arijav/ARILO-RF-Receiver-Transmitter/README.md

# ARILO-RF-Receiver-Transmitter
Open Source / Hardware receiver transmitter for remote controlled model vehicles based on STM32 MCU´s

The PCB's for the transmitter and receiver are shared in OSH Park:
https://oshpark.com/profiles/arigita/
