arijav/ARILO-RF-Receiver-Transmitter/PCB_Design/150109_Modification_Required_Last_Designs.docx

Usarttx 1 y rx están mal, hay que cambiarlos de lado.

Comprobar si diseño de usart es correcto

Ver como están conectados en Taranis vs 9x
