arijav/ARILO-RF-Receiver-Transmitter/PCB_Design/130818_I_T_V_AriloRX_FINAL.brd

## EAGLE design PCB_Design/130818_I_T_V_AriloRX_FINAL.brd (2020-05-03)

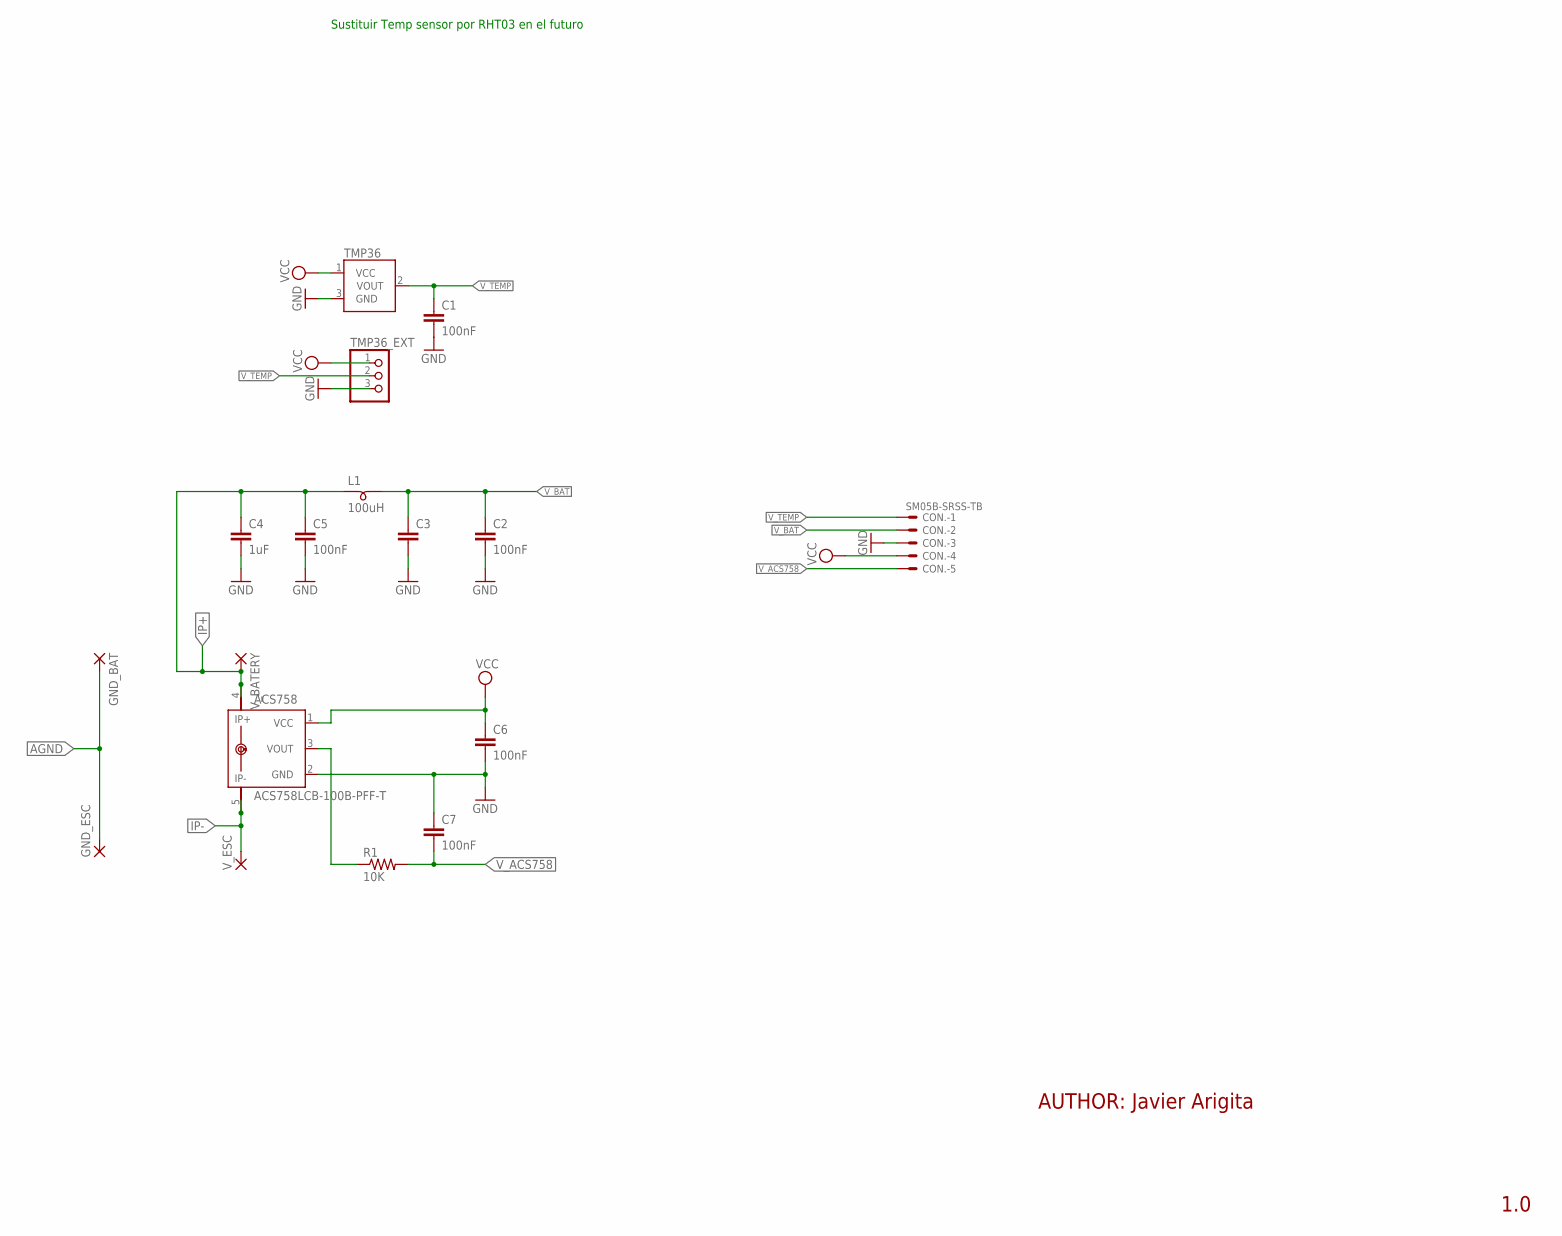
[picture p1: schematic 130818_I_T_V_AriloRX_FINAL.sch]

Parts:
ACS758: ACS758LCB-100B-PFF-T; CB-PFF
C1, C2, C5, C6, C7: 100nF; C0805
C3: C-EUC3216; C3216
C4: 1uF; C3216
CON.: SM05B-SRSS-TB
GND_BAT: SMD5; SMD2,54-5,08
GND_ESC: SMD5; SMD2,54-5,08
L1: 100uH; SM-B5
R1: 10K; R0805
TMP36: TMP36GT9; TO-92
TMP36_EXT: PINHD-1X3; 1X03
V_BATERY: SMD5; SMD2,54-5,08
V_ESC: SMD5; SMD2,54-5,08

Connections:
AGND: GND_BAT.1, GND_ESC.1
GND: ACS758.2 (GND), C1.2, C2.2, C3.2, C4.2, C5.2, C6.2, C7.1, CON..3, TMP36.3 (GND), TMP36_EXT.3
IP+: ACS758.4 (IP+), ACS758.IP+1, C4.1, C5.1, L1.1, V_BATERY.1
IP-: ACS758.5 (IP-), ACS758.IP-1, V_ESC.1
unnamed: ACS758.3 (VOUT), R1.1
VCC: ACS758.1 (VCC), C6.1, CON..4, TMP36.1 (VCC), TMP36_EXT.1
V_ACS758: C7.2, CON..5, R1.2
V_BAT: C2.1, C3.1, CON..2, L1.2
V_TEMP: C1.1, CON..1, TMP36.2 (VOUT), TMP36_EXT.2

Notes on the sheet:
AUTHOR: Javier Arigita
1.0
Sustituir Temp sensor por RHT03 en el futuro

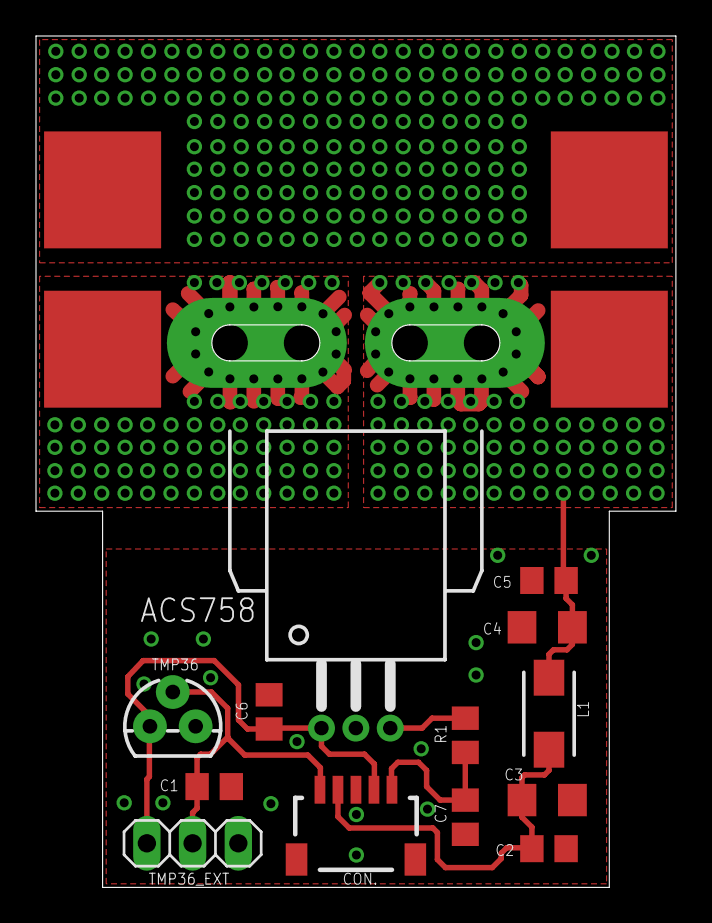
[picture p2: board 130818_I_T_V_AriloRX_FINAL.brd from above]

Board: 2 copper layers, 35.6 x 47.3 mm, 17 parts (0 on the bottom side), 9 nets.
