arijav/ARILO-RF-Receiver-Transmitter/PCB_Design/130627_ReceiverSTM_0_0.brd

## EAGLE design PCB_Design/130627_ReceiverSTM_0_0.brd (2020-05-03)

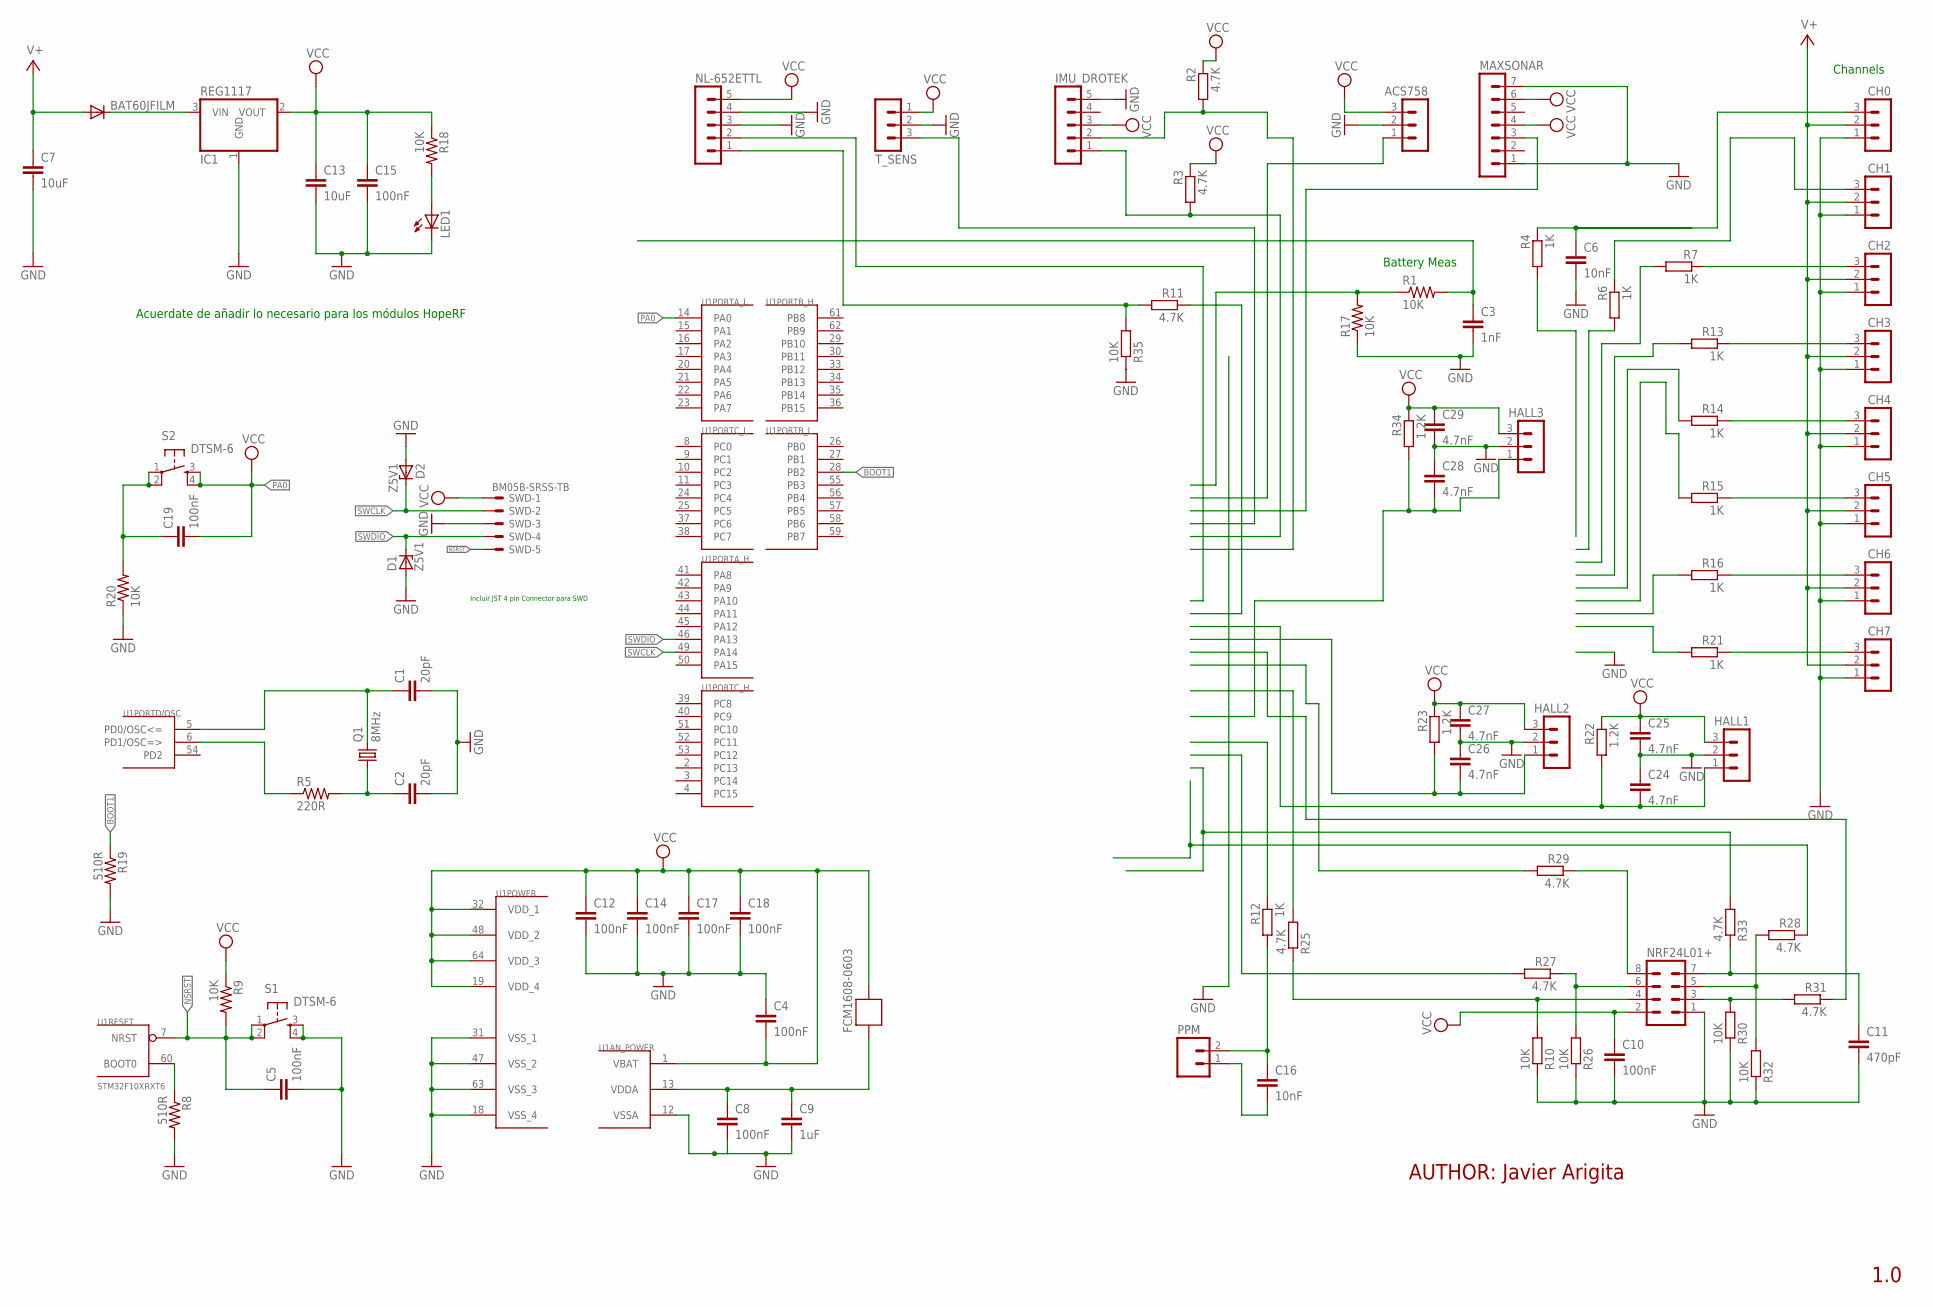
[picture p3: schematic 130627_ReceiverSTM_0_0.sch]

Parts:
ACS758: MA03-1
BAT60JFILM: DIODE-SOD323-R; SOD323-R
C1, C2: 20pF; C0805
C3: 1nF; C0805
C4, C5, C8, C10, C12, C14, C15, C17, C18, C19: 100nF; C0805
C6, C16: 10nF; C025-030X050
C7, C13: 10uF; C3216
C9: 1uF; C3216
C11: 470pF; C025-030X050
C24, C25, C26, C27, C28, C29: 4.7nF; C025-030X050
CH0, CH1, CH2, CH3, CH4, CH5, CH6, CH7: MA03-1
D1, D2: Z5V1; SOD80C
FCM1608-0603: FERRITE-BEAD; R0603
HALL1, HALL2, HALL3: MA03-1
IC1: REG1117; SOT223
IMU_DROTEK: MA05-1
LED1: LED0805; CHIPLED_0805
MAXSONAR: MA07-1
NL-652ETTL: MA05-1
NRF24L01+: MA04-2
PPM: M02; 02P
Q1: 8MHz; SM49
R1, R9, R17, R18, R20: 10K; R0805
R2, R3, R11, R25, R27, R28, R29, R31, R33: 4.7K; 0204/7
R4, R6, R7, R12, R13, R14, R15, R16, R21: 1K; 0204/7
R5: 220R; R0805
R8, R19: 510R; R0805
R10, R26, R30, R32, R35: 10K; 0204/7
R22, R23, R34: 1.2K; 0204/7
S1, S2: DTSM-6
SWD: BM05B-SRSS-TB
T_SENS: MA03-1
U1: STM32F10XRXT6; TQFP64

Connections:
BOOT1: R19.1, U1.28 (PB2)
GND: ACS758.2, C1.2, C2.2, C3.2, C4.1, C5.2, C6.2, C7.2, C8.2, C9.2, C10.2, C11.2, C12.2, C13.2, C14.2, C15.2, C17.2, C18.2, C24.1, C25.2, C26.1, C27.2, C28.1, C29.2, CH0.1, CH1.1, CH2.1, CH3.1, CH4.1, CH5.1, CH6.1, CH7.1, D1.A, D2.A, HALL1.2, HALL2.2, HALL3.2, IC1.1 (GND), IMU_DROTEK.5, LED1.C, MAXSONAR.1, MAXSONAR.7, NL-652ETTL.3, NL-652ETTL.4, NRF24L01+.1, R8.2, R10.1, R17.1, R19.2, R20.1, R26.1, R30.1, R32.1, R35.1, S1.3, S1.4, T_SENS.2, U1.12 (VSSA), U1.18 (VSS_4), U1.31 (VSS_1), U1.47 (VSS_2), U1.63 (VSS_3)
MAX_BRIDGE: NL-652ETTL.2
unnamed: C1.1, Q1.2, U1.5 (PD0/OSC<=)
unnamed: R5.1, U1.6 (PD1/OSC=>)
unnamed: C2.1, Q1.1, R5.2
unnamed: R8.1, U1.60 (BOOT0)
unnamed: C19.1, R20.2, S2.1, S2.2
unnamed: ACS758.3, C25.1, C27.1, C29.1, HALL1.3, HALL2.3, HALL3.3, IMU_DROTEK.3, MAXSONAR.4, MAXSONAR.6, NL-652ETTL.5, R2.1, R3.1, R22.1, R23.1, R34.1, T_SENS.1
unnamed: C16.2, PPM.1
unnamed: IMU_DROTEK.2, R2.2
unnamed: LED1.A, R18.2
unnamed: C28.2, HALL3.1, R34.2
unnamed: BAT60JFILM.C, IC1.3 (VIN)
unnamed: C24.2, HALL1.1, R22.2
unnamed: C3.1, R1.2
unnamed: C8.1, C9.1, FCM1608-0603.2, U1.13 (VDDA)
unnamed: NRF24L01+.4, R10.2, R25.1
unnamed: NRF24L01+.3, R30.2, R31.2
unnamed: C16.1, PPM.2, R12.2
unnamed: NL-652ETTL.1, R11.2, R35.2
unnamed: IMU_DROTEK.1, R3.2
unnamed: C26.2, HALL2.1, R23.2
unnamed: R1.1, R17.2
unnamed: NRF24L01+.8, R29.1
unnamed: NRF24L01+.6, R26.2, R27.1
unnamed: NRF24L01+.5, R28.2, R32.2
unnamed: C11.1, NRF24L01+.7, R33.1
unnamed: C6.1, CH0.3, R4.1
unnamed: CH1.3, R6.1
unnamed: CH2.3, R7.1
unnamed: CH3.3, R13.1
unnamed: CH4.3, R14.1
unnamed: CH5.3, R15.1
unnamed: CH6.3, R16.1
unnamed: CH7.3, R21.1
NSRST: C5.1, R9.2, S1.1, S1.2, SWD.5, U1.7 (NRST)
PA0: C4.2, C10.1, C12.1, C13.1, C14.1, C15.1, C17.1, C18.1, C19.2, FCM1608-0603.1, IC1.2 (VOUT), NRF24L01+.2, R9.1, R18.1, S2.3, S2.4, U1.1 (VBAT), U1.14 (PA0), U1.19 (VDD_4), U1.48 (VDD_2), U1.64 (VDD_3)
SWCLK: D2.C, SWD.2, SWD.3, U1.49 (PA14)
SWDIO: D1.C, SWD.4, U1.46 (PA13)
V+: BAT60JFILM.A, C7.1, CH0.2, CH1.2, CH2.2, CH3.2, CH4.2, CH5.2, CH6.2, CH7.2
VCC: SWD.1
VDD_1: U1.32 (VDD_1)

Notes on the sheet:
Battery Meas
Acuerdate de añadir lo necesario para los módulos HopeRF
AUTHOR: Javier Arigita
1.0
Channels
Incluir JST 4 pin Connector para SWD

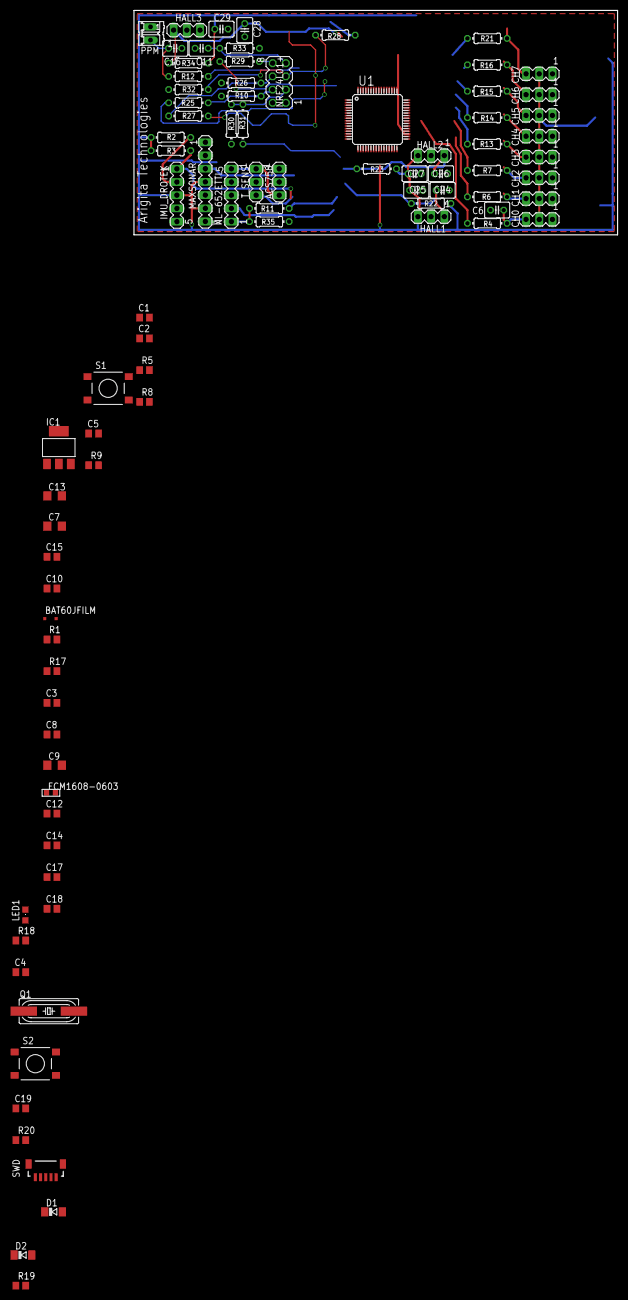
[picture p4: board 130627_ReceiverSTM_0_0.brd from above]

Board: 2 copper layers, 93.0 x 43.2 mm, 88 parts (0 on the bottom side), 40 nets.
