arijav/ARILO-RF-Receiver-Transmitter/PCB_Design/150309_AriloRX_REV3_0_0.brd

## EAGLE design PCB_Design/150309_AriloRX_REV3_0_0.brd (2020-05-03, an earlier design)

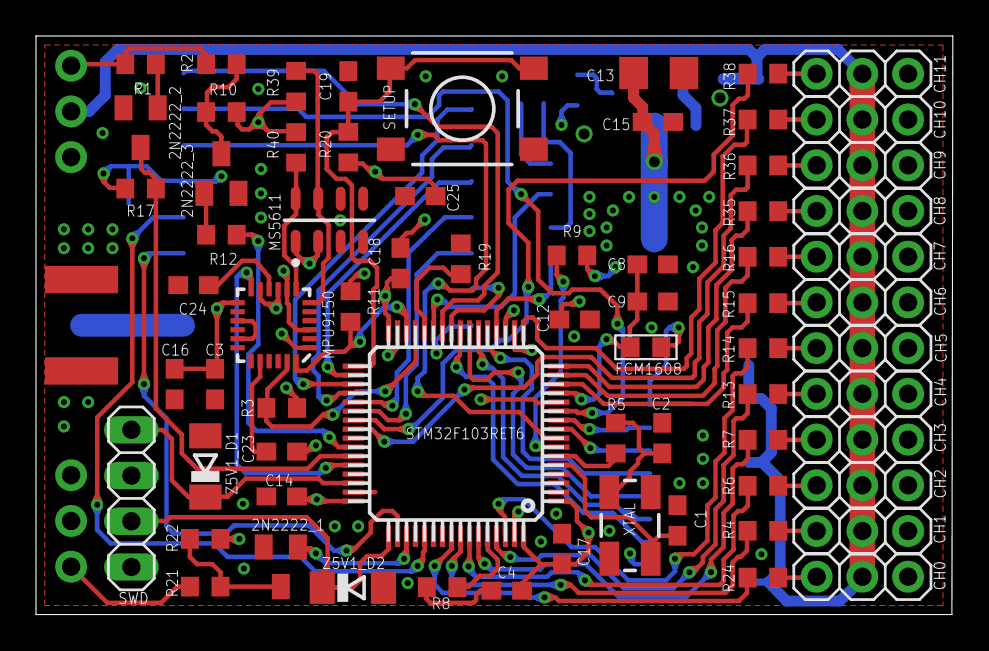
[picture p5: board 150309_AriloRX_REV3_0_0.brd from above]

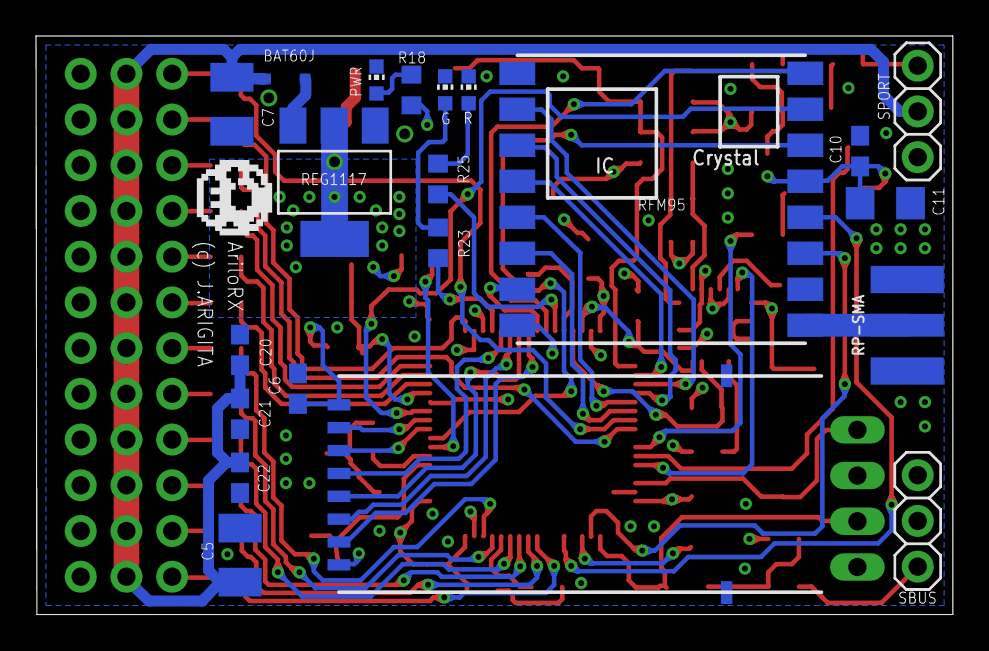
[picture p6: board 150309_AriloRX_REV3_0_0.brd from below]

Board: 4 copper layers, 50.9 x 32.1 mm, 90 parts (21 on the bottom side), 77 nets.

Parts:
2N2222_1, 2N2222_2, 2N2222_3: SOT23-BEC
BAT60J: SOD323-R
C1, C2: 12pF; RESISTOR_C0603
C3, C4, C6, C8, C10, C12, C14, C15, C17, C18, C19, C20, C24, C25: 100nF; RESISTOR_C0603
C5: SMC_B
C7: 100uF; SMC_B
C9: 1uF; RESISTOR_C0603
C11, C13: 10uF; RESISTOR_C3216
C16, C21: 10nF; RESISTOR_C0603
C22: 1nF; RESISTOR_C0603
C23: 2.2nF; RESISTOR_C0603
CH0, CH1, CH2, CH3, CH4, CH5, CH6, CH7, CH8, CH9, CH10, CH11: 1X03
FCM1608: R0603
G: CHIP-LED0603
MPU9150: QFN-24-NP
MS5611: MS5611-01BA03; SON125P300X500X100-8N
NRF24L01_SMD: NRF24L01+_NRF24L01_SMDSMD; NRF24L01+_NRF24L01_SMD
PWR: LED_CHIP-LED0603
R: CHIP-LED0603
R1, R9, R18, R20: 10K; RCL_R0603
R2, R4, R6, R7, R10, R12, R13, R14, R15, R16, R21, R22, R24, R35, R36, R37, R38: 1K; RCL_R0603
R3, R11, R17, R39, R40: 4.7K; RCL_R0603
R5: 80R; RCL_R0603
R8, R19: 510R; RCL_R0603
R23, R25: 220; RCL_R0603
REG1117: REG1117; SOT223
RFM95: RFM95W_MISIEK_RFM95WSMD; RFM95W_MISIEK_RFM95W_SMD
RP-SMA: SMA_EDGELAUNCH
SBUS: 1X03
SETUP: DTSM-6
SPORT: 1X03
STM32F103RET6: STM32F103RET6; TQFP64
SWD: 1X04
XTAL: 12MHz; CRYSTAL-SMD-5X3
Z5V1_D1, Z5V1_D2: Z5V1; SOD80C

Connections:
BOOT1: R19.1, STM32F103RET6.28
CH0: R24.2, STM32F103RET6.56
CH1: R4.2, STM32F103RET6.57
CH2: R6.2, STM32F103RET6.58
CH3: R7.2, STM32F103RET6.59
CH4: R13.2, STM32F103RET6.61
CH5: R14.2, STM32F103RET6.62
CH6: R15.2, STM32F103RET6.14
CH7: R16.2, STM32F103RET6.15
CH8: R35.2, STM32F103RET6.16
CH9: R36.2, STM32F103RET6.40
CH10: R37.2, STM32F103RET6.17
CH11: R38.2, STM32F103RET6.39
GND: 2N2222_1.E, 2N2222_2.E, 2N2222_3.E, C1.2, C2.2, C3.2, C4.1, C5.-, C6.2, C7.-, C8.2, C9.2, C10.2, C11.2, C12.2, C13.2, C14.2, C15.2, C16.2, C17.2, C18.2, C19.1, C20.2, C21.2, C22.2, C23.2, C24.2, C25.2, CH0.1, CH1.1, CH2.1, CH3.1, CH4.1, CH5.1, CH6.1, CH7.1, CH8.1, CH9.1, CH10.1, CH11.1, G.C, MPU9150.1, MPU9150.9, MPU9150.11, MPU9150.15, MPU9150.17, MPU9150.18, MS5611.3, MS5611.4, MS5611.5, NRF24L01_SMD.P$1, PWR.C, R.C, R8.2, R19.2, REG1117.1, RFM95.1, RFM95.8, RFM95.10, RP-SMA.GND@1, RP-SMA.GND@2, RP-SMA.GND@3, RP-SMA.GND@4, SBUS.3, SETUP.1, SETUP.2, SPORT.3, STM32F103RET6.12, STM32F103RET6.18, STM32F103RET6.31, STM32F103RET6.47, STM32F103RET6.63, SWD.3, Z5V1_D1.A, Z5V1_D2.A
HOPERF_CSN: RFM95.5, STM32F103RET6.37
HOPERF_DIO0: RFM95.14, STM32F103RET6.8
HOPERF_DIO1: RFM95.15, STM32F103RET6.11
HOPERF_DIO2: RFM95.16, STM32F103RET6.26
HOPERF_DIO3: RFM95.11, STM32F103RET6.50
HOPERF_DIO4: RFM95.12, STM32F103RET6.53
HOPERF_DIO5: RFM95.7, STM32F103RET6.25
HOPERF_RESET: RFM95.6, STM32F103RET6.38
I2C2_SCL: MPU9150.23, R3.2, STM32F103RET6.29
I2C2_SDA: MPU9150.24, R11.1, STM32F103RET6.30
INP_1: C19.2, R20.1, SETUP.3, SETUP.4, STM32F103RET6.33
LED_GREEN: R23.2, STM32F103RET6.20
LED_RED: R25.2, STM32F103RET6.27
MPU_INT: MPU9150.12, STM32F103RET6.44
unnamed: C1.1, STM32F103RET6.5, XTAL.3
unnamed: R5.1, STM32F103RET6.6
unnamed: C2.1, R5.2, XTAL.1
unnamed: R8.1, STM32F103RET6.60
unnamed: 2N2222_3.C, R2.2, R10.2
unnamed: RFM95.9, RP-SMA.P
unnamed: 2N2222_3.B, R12.1
unnamed: CH0.3, R24.1
unnamed: PWR.A, R18.2
unnamed: 2N2222_1.C, R21.2, R22.2
unnamed: G.A, R23.1
unnamed: CH8.3, R35.1
unnamed: R1.1, R2.1, SPORT.1
unnamed: R.A, R25.1
unnamed: 2N2222_2.B, R1.2
unnamed: C8.1, C9.1, FCM1608.2, STM32F103RET6.13
unnamed: CH2.3, R6.1
unnamed: CH4.3, R13.1
unnamed: CH9.3, R36.1
unnamed: CH10.3, R37.1
unnamed: CH11.3, R38.1
unnamed: MPU9150.7, MS5611.8, R40.1
unnamed: MPU9150.6, MS5611.7, R39.2
unnamed: CH3.3, R7.1
unnamed: CH6.3, R15.1
unnamed: C23.1, MPU9150.20
unnamed: CH5.3, R14.1
unnamed: CH7.3, R16.1
unnamed: C24.1, MPU9150.10
unnamed: CH1.3, R4.1
NRF_CE: NRF24L01_SMD.P$7, STM32F103RET6.10
NRF_CSN: NRF24L01_SMD.P$6, STM32F103RET6.9
NRF_IRQ: NRF24L01_SMD.P$2, STM32F103RET6.24
NSRST: R9.2, STM32F103RET6.7
SBUS: R21.1, SBUS.1
SPI1_MISO: NRF24L01_SMD.P$3, STM32F103RET6.22
SPI1_MOSI: NRF24L01_SMD.P$4, STM32F103RET6.23
SPI1_SCK: NRF24L01_SMD.P$5, STM32F103RET6.21
SPI2_MISO: RFM95.2, STM32F103RET6.35
SPI2_MOSI: RFM95.3, STM32F103RET6.36
SPI2_SCK: RFM95.4, STM32F103RET6.34
SWCLK: STM32F103RET6.49, SWD.2, Z5V1_D2.C
SWDIO: STM32F103RET6.46, SWD.4, Z5V1_D1.C
USART1_RX: 2N2222_2.C, R17.2, STM32F103RET6.43
USART1_TX: R12.2, STM32F103RET6.42
USART3_TX: 2N2222_1.B, STM32F103RET6.51
V+: BAT60J.A, C5.+, C7.+, C20.1, C21.1, C22.1, CH0.2, CH1.2, CH2.2, CH3.2, CH4.2, CH5.2, CH6.2, CH7.2, CH8.2, CH9.2, CH10.2, CH11.2, SBUS.2, SPORT.2
VCC: C3.1, C4.2, C6.1, C10.1, C11.1, C12.1, C13.1, C14.1, C15.1, C16.1, C17.1, C18.1, C25.1, FCM1608.1, MPU9150.3, MPU9150.8, MPU9150.13, MS5611.1, MS5611.2, NRF24L01_SMD.P$8, R3.1, R9.1, R10.1, R11.2, R17.1, R18.1, R20.2, R22.1, R39.1, R40.2, REG1117.2, REG1117.4, RFM95.13, STM32F103RET6.1, STM32F103RET6.19, STM32F103RET6.32, STM32F103RET6.48, STM32F103RET6.64, SWD.1
VDD: BAT60J.C, REG1117.3
