arijav/ARILO-RF-Receiver-Transmitter/ARILO_RX/src/Project_Files/main.c

/*------------------------------------------------------------------------------*/
/*                                                                              */
/* NAME:             main.c                                                     */
/*                                                                              */
/* DESCRIPTION:      Main function. Call every Task and distribute events among */
/*                   State Machines                                             */
/*                                                                              */
/* VERSION:          1.0                                                        */
/*                                                                              */
/*------------------------------------------------------------------------------*/

/*------------------------------------------------------------------------------*/
/* Header-Files (#include)                                                      */
/*------------------------------------------------------------------------------*/
#include "Event_Manager/event_manager.h"
#include "Event_Manager/state_machine_fw.h"
#include "System/HAL/hw_general.h"

/*------------------------------------------------------------------------------*/
/* Global Variables                                                             */
/*------------------------------------------------------------------------------*/

/*------------------------------------------------------------------------------*/
/* Local Variables                                                              */
/*------------------------------------------------------------------------------*/

/*------------------------------------------------------------------------------*/
/* Local Function Prototypes                                                    */
/*------------------------------------------------------------------------------*/

/*------------------------------------------------------------------------------*/
/* Functions                                                                    */
/*------------------------------------------------------------------------------*/

int main(void)
{
	/* Initiate State Machines */
    init_statem();

	/* Initial setup of the system HW */
	hw_init();

	/* Delegates the task execution into the event manager processor */
	event_processor_main();

	return 0;
}
