arijav/ARILO-RF-Receiver-Transmitter/ARILO_RX/src/Project_Files/System/Modules/RF/hw_hoperf.h

/*------------------------------------------------------------------------------*/
/*                                                                              */
/* NAME:             hw_hoperf.h                                                */
/*                                                                              */
/* DESCRIPTION:      Control Transceiver RFM23bp                                */
/*                                                                              */
/* VERSION:          1.0                                                        */
/*                                                                              */
/*------------------------------------------------------------------------------*/

#ifndef HW_HOPERF_H_
#define HW_HOPERF_H_

/*------------------------------------------------------------------------------*/
/* Header-Files (#include)                                                      */
/*------------------------------------------------------------------------------*/
#include "Arilo_Types.h"

/*------------------------------------------------------------------------------*/
/* Defines                                                                      */
/*------------------------------------------------------------------------------*/

/* Rates */
#define RATE_VERYSLOW 1
#define RATE_SLOW     2
#define RATE_FAST     3

// This is the bit in the SPI address that marks it as a write
#define HOPERF_SPI_WRITE_MASK 0x80

// This is the maximum message length that can be supported by this library. Limited by
// the single message length octet in the header.
// Yes, 255 is correct even though the FIFO size in the HOPERF is only
// 64 octets. We use interrupts to refill the Tx FIFO during transmission and to empty the
// Rx FIFO during reception
// Can be pre-defined to a smaller size (to save SRAM) prior to including this header
#define HOPERF_MAX_MESSAGE_LEN_TX SL_TX_PLOAD_WIDTH
#define HOPERF_MAX_MESSAGE_LEN_RX SL_RX_PLOAD_WIDTH

// Max number of octets the HOPERF Rx and Tx FIFOs can hold
#define HOPERF_FIFO_SIZE 64

// Keep track of the mode the HOPERF is in
#define HOPERF_MODE_IDLE         0
#define HOPERF_MODE_RX           1
#define HOPERF_MODE_TX           2

// These values we set for FIFO thresholds (4, 55) are actually the same as the POR values
#define HOPERF_TXFFAEM_THRESHOLD 4
#define HOPERF_RXFFAFULL_THRESHOLD 55

// This is the default node address,
#define HOPERF_DEFAULT_NODE_ADDRESS 0x12

// This address in the TO addreess signifies a broadcast
#define HOPERF_BROADCAST_ADDRESS 0xff

// Number of registers to be passed to setModemConfig()
#define HOPERF_NUM_MODEM_CONFIG_REGS 18

// Register names
#define HOPERF_REG_00_DEVICE_TYPE                         0x00
#define HOPERF_REG_01_VERSION_CODE                        0x01
#define HOPERF_REG_02_DEVICE_STATUS                       0x02
#define HOPERF_REG_03_INTERRUPT_STATUS1                   0x03
#define HOPERF_REG_04_INTERRUPT_STATUS2                   0x04
#define HOPERF_REG_05_INTERRUPT_ENABLE1                   0x05
#define HOPERF_REG_06_INTERRUPT_ENABLE2                   0x06
#define HOPERF_REG_07_OPERATING_MODE1                     0x07
#define HOPERF_REG_08_OPERATING_MODE2                     0x08
#define HOPERF_REG_09_OSCILLATOR_LOAD_CAPACITANCE         0x09
#define HOPERF_REG_0A_UC_OUTPUT_CLOCK                     0x0a
#define HOPERF_REG_0B_GPIO_CONFIGURATION0                 0x0b
#define HOPERF_REG_0C_GPIO_CONFIGURATION1                 0x0c
#define HOPERF_REG_0D_GPIO_CONFIGURATION2                 0x0d
#define HOPERF_REG_0E_IO_PORT_CONFIGURATION               0x0e
#define HOPERF_REG_0F_ADC_CONFIGURATION                   0x0f
#define HOPERF_REG_10_ADC_SENSOR_AMP_OFFSET               0x10
#define HOPERF_REG_11_ADC_VALUE                           0x11
#define HOPERF_REG_12_TEMPERATURE_SENSOR_CALIBRATION      0x12
#define HOPERF_REG_13_TEMPERATURE_VALUE_OFFSET            0x13
#define HOPERF_REG_14_WAKEUP_TIMER_PERIOD1                0x14
#define HOPERF_REG_15_WAKEUP_TIMER_PERIOD2                0x15
#define HOPERF_REG_16_WAKEUP_TIMER_PERIOD3                0x16
#define HOPERF_REG_17_WAKEUP_TIMER_VALUE1                 0x17
#define HOPERF_REG_18_WAKEUP_TIMER_VALUE2                 0x18
#define HOPERF_REG_19_LDC_MODE_DURATION                   0x19
#define HOPERF_REG_1A_LOW_BATTERY_DETECTOR_THRESHOLD      0x1a
#define HOPERF_REG_1B_BATTERY_VOLTAGE_LEVEL               0x1b
#define HOPERF_REG_1C_IF_FILTER_BANDWIDTH                 0x1c
#define HOPERF_REG_1D_AFC_LOOP_GEARSHIFT_OVERRIDE         0x1d
#define HOPERF_REG_1E_AFC_TIMING_CONTROL                  0x1e
#define HOPERF_REG_1F_CLOCK_RECOVERY_GEARSHIFT_OVERRIDE   0x1f
#define HOPERF_REG_20_CLOCK_RECOVERY_OVERSAMPLING_RATE    0x20
#define HOPERF_REG_21_CLOCK_RECOVERY_OFFSET2              0x21
#define HOPERF_REG_22_CLOCK_RECOVERY_OFFSET1              0x22
#define HOPERF_REG_23_CLOCK_RECOVERY_OFFSET0              0x23
#define HOPERF_REG_24_CLOCK_RECOVERY_TIMING_LOOP_GAIN1    0x24
#define HOPERF_REG_25_CLOCK_RECOVERY_TIMING_LOOP_GAIN0    0x25
#define HOPERF_REG_26_RSSI                                0x26
#define HOPERF_REG_27_RSSI_THRESHOLD                      0x27
#define HOPERF_REG_28_ANTENNA_DIVERSITY1                  0x28
#define HOPERF_REG_29_ANTENNA_DIVERSITY2                  0x29
#define HOPERF_REG_2A_AFC_LIMITER                         0x2a
#define HOPERF_REG_2B_AFC_CORRECTION_READ                 0x2b
#define HOPERF_REG_2C_OOK_COUNTER_VALUE_1                 0x2c
#define HOPERF_REG_2D_OOK_COUNTER_VALUE_2                 0x2d
#define HOPERF_REG_2E_SLICER_PEAK_HOLD                    0x2e
#define HOPERF_REG_30_DATA_ACCESS_CONTROL                 0x30
#define HOPERF_REG_31_EZMAC_STATUS                        0x31
#define HOPERF_REG_32_HEADER_CONTROL1                     0x32
#define HOPERF_REG_33_HEADER_CONTROL2                     0x33
#define HOPERF_REG_34_PREAMBLE_LENGTH                     0x34
#define HOPERF_REG_35_PREAMBLE_DETECTION_CONTROL1         0x35
#define HOPERF_REG_36_SYNC_WORD3                          0x36
#define HOPERF_REG_37_SYNC_WORD2                          0x37
#define HOPERF_REG_38_SYNC_WORD1                          0x38
#define HOPERF_REG_39_SYNC_WORD0                          0x39
#define HOPERF_REG_3A_TRANSMIT_HEADER3                    0x3a
#define HOPERF_REG_3B_TRANSMIT_HEADER2                    0x3b
#define HOPERF_REG_3C_TRANSMIT_HEADER1                    0x3c
#define HOPERF_REG_3D_TRANSMIT_HEADER0                    0x3d
#define HOPERF_REG_3E_PACKET_LENGTH                       0x3e
#define HOPERF_REG_3F_CHECK_HEADER3                       0x3f
#define HOPERF_REG_40_CHECK_HEADER2                       0x40
#define HOPERF_REG_41_CHECK_HEADER1                       0x41
#define HOPERF_REG_42_CHECK_HEADER0                       0x42
#define HOPERF_REG_43_HEADER_ENABLE3                      0x43
#define HOPERF_REG_44_HEADER_ENABLE2                      0x44
#define HOPERF_REG_45_HEADER_ENABLE1                      0x45
#define HOPERF_REG_46_HEADER_ENABLE0                      0x46
#define HOPERF_REG_47_RECEIVED_HEADER3                    0x47
#define HOPERF_REG_48_RECEIVED_HEADER2                    0x48
#define HOPERF_REG_49_RECEIVED_HEADER1                    0x49
#define HOPERF_REG_4A_RECEIVED_HEADER0                    0x4a
#define HOPERF_REG_4B_RECEIVED_PACKET_LENGTH              0x4b
#define HOPERF_REG_50_ANALOG_TEST_BUS_SELECT              0x50
#define HOPERF_REG_51_DIGITAL_TEST_BUS_SELECT             0x51
#define HOPERF_REG_52_TX_RAMP_CONTROL                     0x52
#define HOPERF_REG_53_PLL_TUNE_TIME                       0x53
#define HOPERF_REG_55_CALIBRATION_CONTROL                 0x55
#define HOPERF_REG_56_MODEM_TEST                          0x56
#define HOPERF_REG_57_CHARGE_PUMP_TEST                    0x57
#define HOPERF_REG_58_CHARGE_PUMP_CURRENT_TRIMMING        0x58
#define HOPERF_REG_59_DIVIDER_CURRENT_TRIMMING            0x59
#define HOPERF_REG_5A_VCO_CURRENT_TRIMMING                0x5a
#define HOPERF_REG_5B_VCO_CALIBRATION                     0x5b
#define HOPERF_REG_5C_SYNTHESIZER_TEST                    0x5c
#define HOPERF_REG_5D_BLOCK_ENABLE_OVERRIDE1              0x5d
#define HOPERF_REG_5E_BLOCK_ENABLE_OVERRIDE2              0x5e
#define HOPERF_REG_5F_BLOCK_ENABLE_OVERRIDE3              0x5f
#define HOPERF_REG_60_CHANNEL_FILTER_COEFFICIENT_ADDRESS  0x60
#define HOPERF_REG_61_CHANNEL_FILTER_COEFFICIENT_VALUE    0x61
#define HOPERF_REG_62_CRYSTAL_OSCILLATOR_POR_CONTROL      0x62
#define HOPERF_REG_63_RC_OSCILLATOR_COARSE_CALIBRATION    0x63
#define HOPERF_REG_64_RC_OSCILLATOR_FINE_CALIBRATION      0x64
#define HOPERF_REG_65_LDO_CONTROL_OVERRIDE                0x65
#define HOPERF_REG_66_LDO_LEVEL_SETTINGS                  0x66
#define HOPERF_REG_67_DELTA_SIGMA_ADC_TUNING1             0x67
#define HOPERF_REG_68_DELTA_SIGMA_ADC_TUNING2             0x68
#define HOPERF_REG_69_AGC_OVERRIDE1                       0x69
#define HOPERF_REG_6A_AGC_OVERRIDE2                       0x6a
#define HOPERF_REG_6B_GFSK_FIR_FILTER_COEFFICIENT_ADDRESS 0x6b
#define HOPERF_REG_6C_GFSK_FIR_FILTER_COEFFICIENT_VALUE   0x6c
#define HOPERF_REG_6D_TX_POWER                            0x6d
#define HOPERF_REG_6E_TX_DATA_RATE1                       0x6e
#define HOPERF_REG_6F_TX_DATA_RATE0                       0x6f
#define HOPERF_REG_70_MODULATION_CONTROL1                 0x70
#define HOPERF_REG_71_MODULATION_CONTROL2                 0x71
#define HOPERF_REG_72_FREQUENCY_DEVIATION                 0x72
#define HOPERF_REG_73_FREQUENCY_OFFSET1                   0x73
#define HOPERF_REG_74_FREQUENCY_OFFSET2                   0x74
#define HOPERF_REG_75_FREQUENCY_BAND_SELECT               0x75
#define HOPERF_REG_76_NOMINAL_CARRIER_FREQUENCY1          0x76
#define HOPERF_REG_77_NOMINAL_CARRIER_FREQUENCY0          0x77
#define HOPERF_REG_79_FREQUENCY_HOPPING_CHANNEL_SELECT    0x79
#define HOPERF_REG_7A_FREQUENCY_HOPPING_STEP_SIZE         0x7a
#define HOPERF_REG_7C_TX_FIFO_CONTROL1                    0x7c
#define HOPERF_REG_7D_TX_FIFO_CONTROL2                    0x7d
#define HOPERF_REG_7E_RX_FIFO_CONTROL                     0x7e
#define HOPERF_REG_7F_FIFO_ACCESS                         0x7f

// These register masks etc are named wherever possible
// corresponding to the bit and field names in the RF-22 Manual
// HOPERF_REG_00_DEVICE_TYPE                      0x00
#define HOPERF_DEVICE_TYPE_RX_TRX                 0x08
#define HOPERF_DEVICE_TYPE_TX                     0x07

// HOPERF_REG_02_DEVICE_STATUS                    0x02
#define HOPERF_FFOVL                              0x80
#define HOPERF_FFUNFL                             0x40
#define HOPERF_RXFFEM                             0x20
#define HOPERF_HEADERR                            0x10
#define HOPERF_FREQERR                            0x08
#define HOPERF_LOCKDET                            0x04
#define HOPERF_CPS                                0x03
#define HOPERF_CPS_IDLE                           0x00
#define HOPERF_CPS_RX                             0x01
#define HOPERF_CPS_TX                             0x10

// HOPERF_REG_03_INTERRUPT_STATUS1                0x03
#define HOPERF_IFFERROR                           0x80
#define HOPERF_ITXFFAFULL                         0x40
#define HOPERF_ITXFFAEM                           0x20
#define HOPERF_IRXFFAFULL                         0x10
#define HOPERF_IEXT                               0x08
#define HOPERF_IPKSENT                            0x04
#define HOPERF_IPKVALID                           0x02
#define HOPERF_ICRCERROR                          0x01
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
